Busboombot/usb-power-switch/design/cad/renders/bottom_molex.png

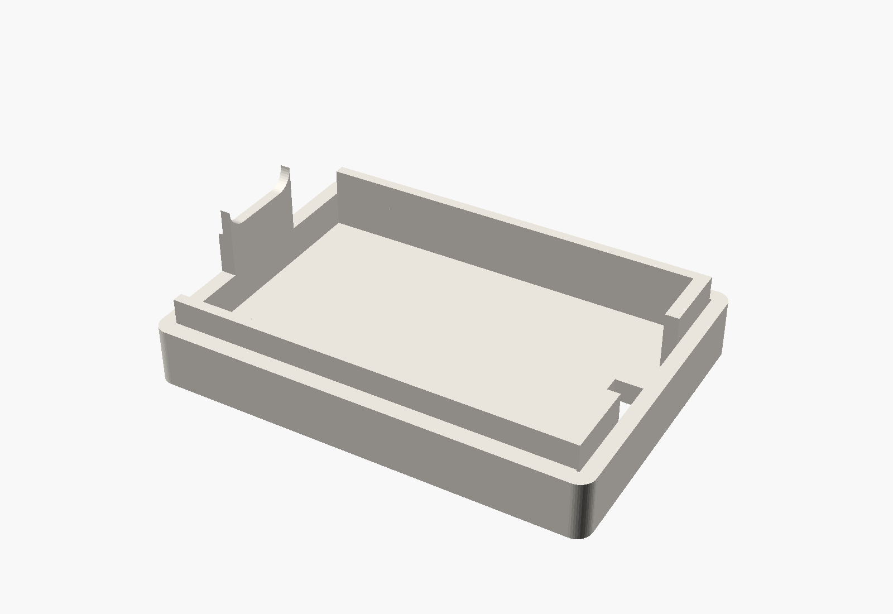
design/cad/renders/bottom_molex.png
