Busboombot/usb-power-switch/design/cad/renders/carrier_top.png

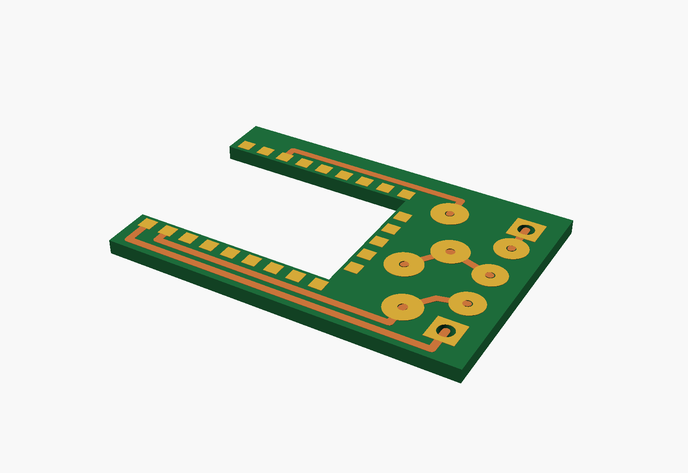
design/cad/renders/carrier_top.png
