Busboombot/usb-power-switch/design/cad/renders/lid_cable.png

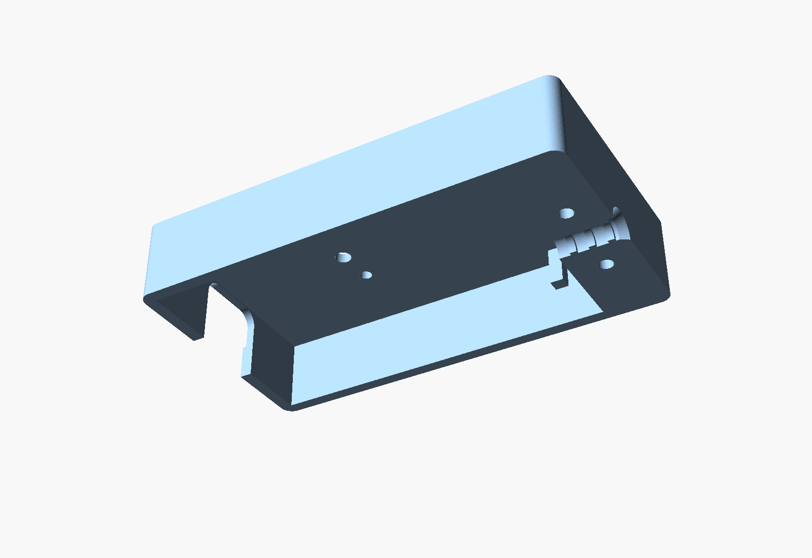
design/cad/renders/lid_cable.png
