Busboombot/usb-power-switch/design/cad/renders/module_bottom.png

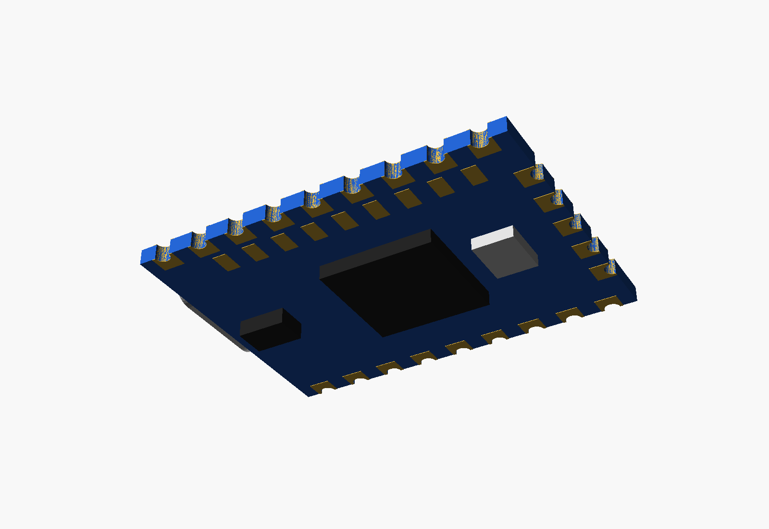
design/cad/renders/module_bottom.png
