Busboombot/usb-power-switch/design/cad/renders/section_molex.png

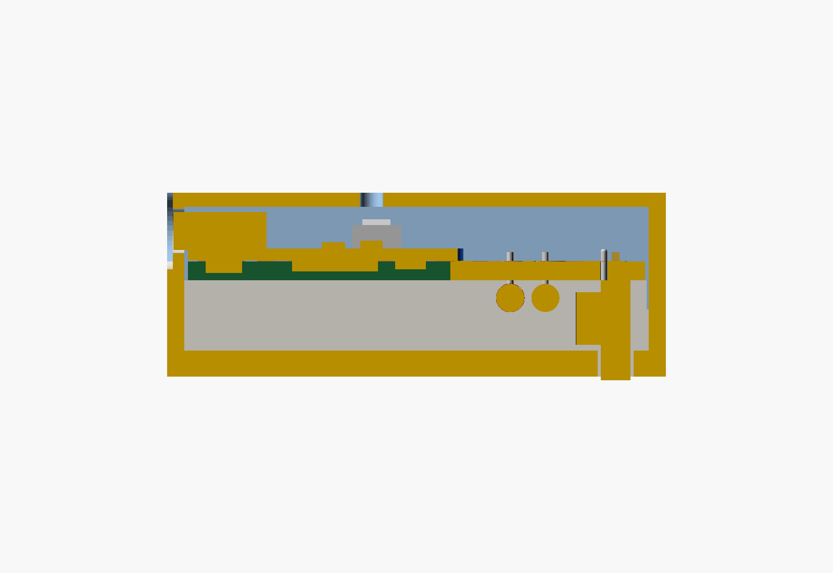
design/cad/renders/section_molex.png
