Busboombot/usb-power-switch/design/scan/height_bottom.png

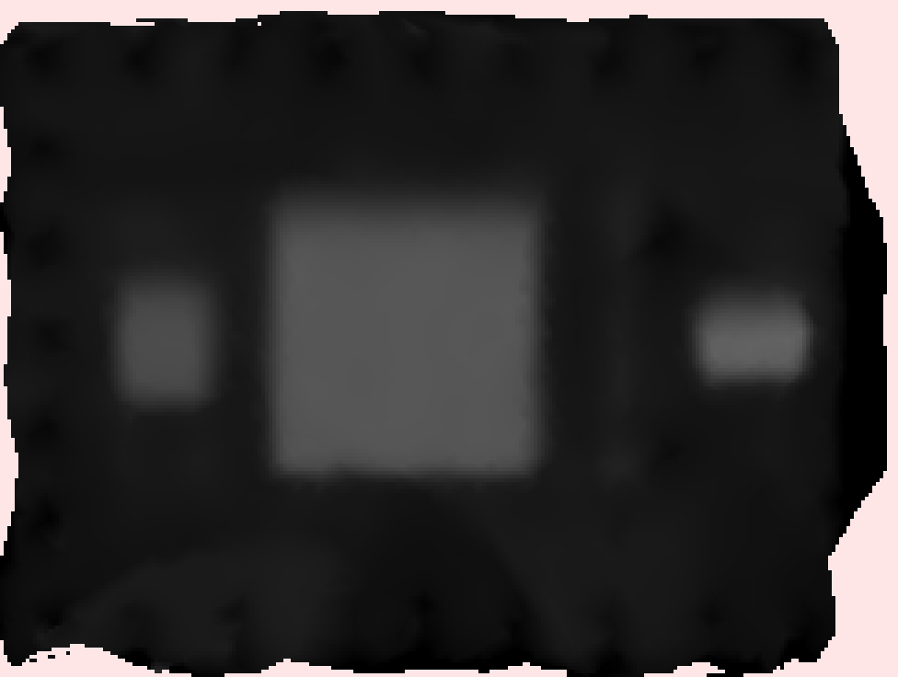
design/scan/height_bottom.png
