Busboombot/usb-power-switch/design/scan/height_top.png

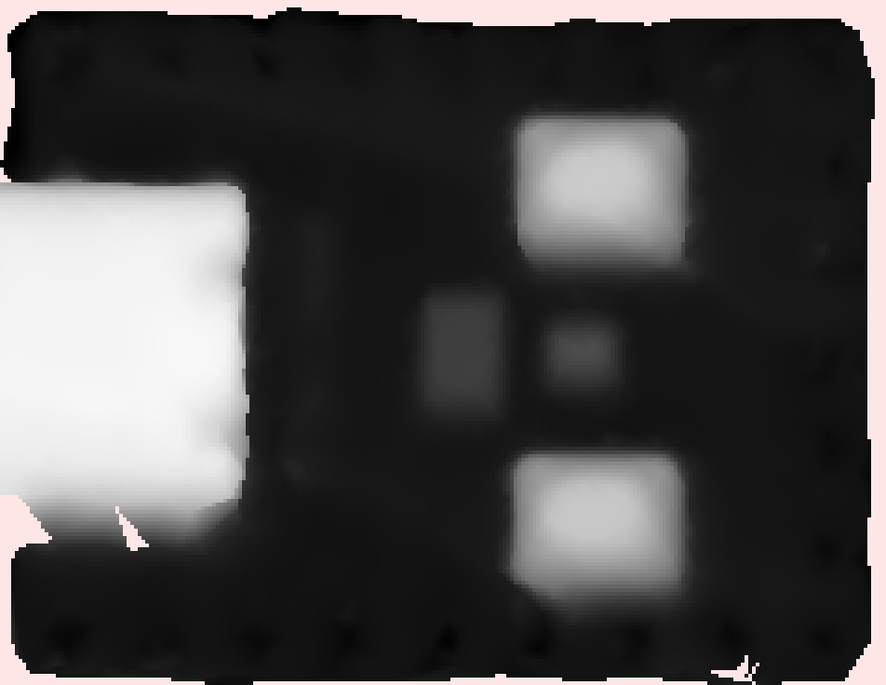
design/scan/height_top.png
