Busboombot/usb-power-switch/tools/mill/blank/pcb_blank_scan_170544.png

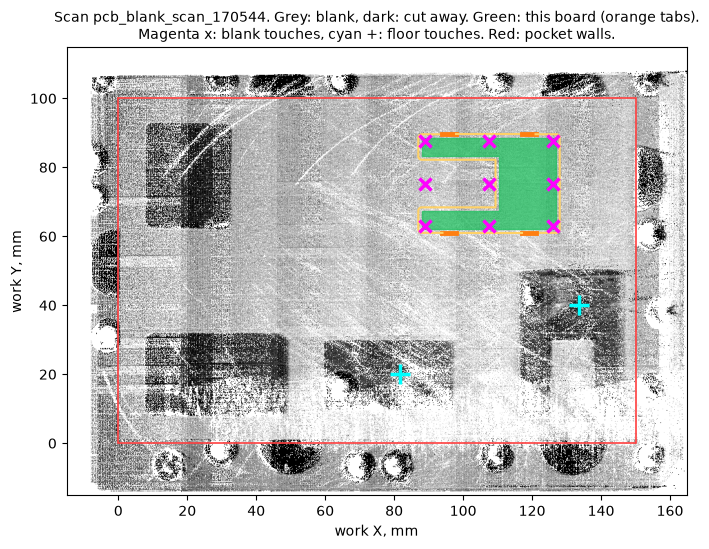
tools/mill/blank/pcb_blank_scan_170544.png
