Busboombot/usb-power-switch/tools/mill/blank/pcb_blank_scan_211856.png

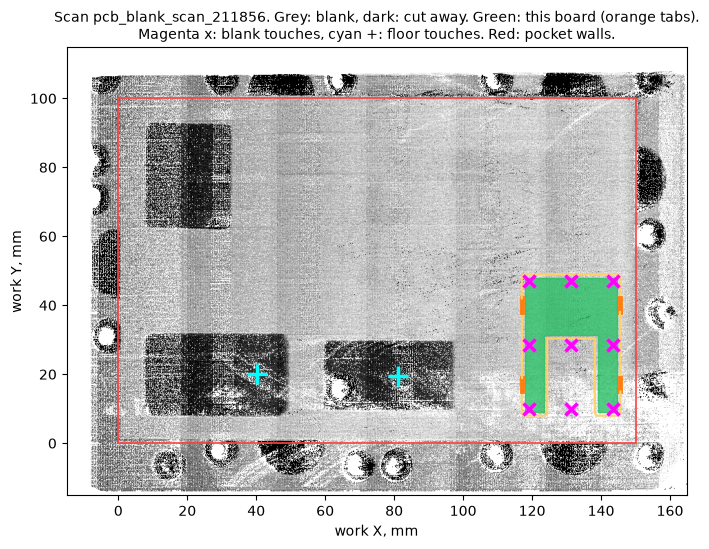
tools/mill/blank/pcb_blank_scan_211856.png
