Busboombot/usb-power-switch/design/scan/rp2040-zero-scan.stl

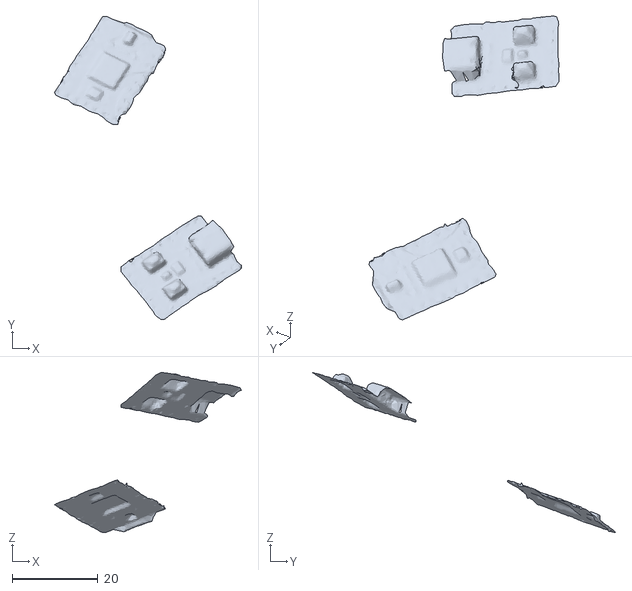
[picture p20: CAD file, 2026-11-08]
design/scan/rp2040-zero-scan.stl
43.5 x 70.6 x 37.3
