Busboombot/usb-power-switch/design/cad/renders/assembly_cable.png

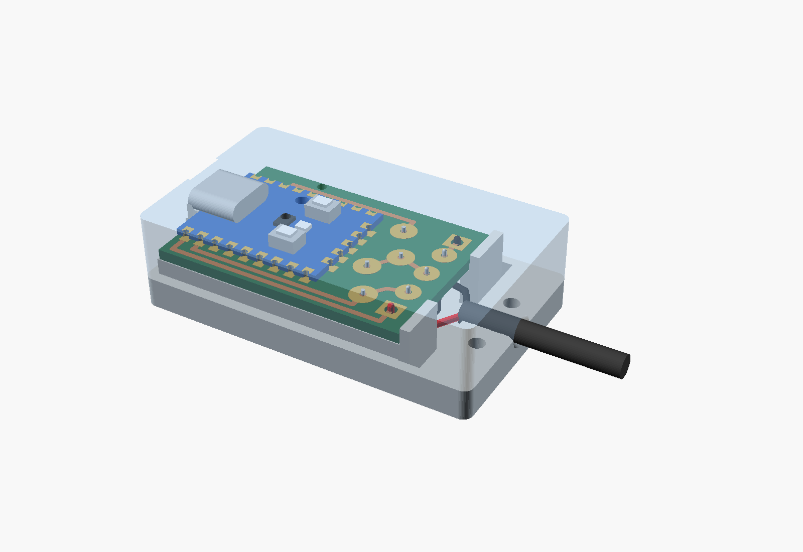
design/cad/renders/assembly_cable.png
