Busboombot/usb-power-switch/design/cad/renders/assembly_cable_back.png

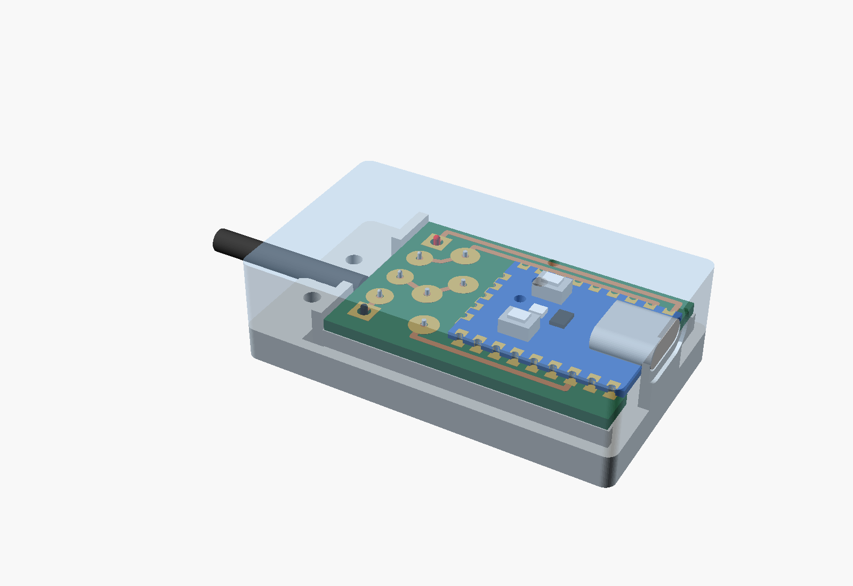
design/cad/renders/assembly_cable_back.png
