Busboombot/usb-power-switch/design/cad/renders/assembly_molex.png

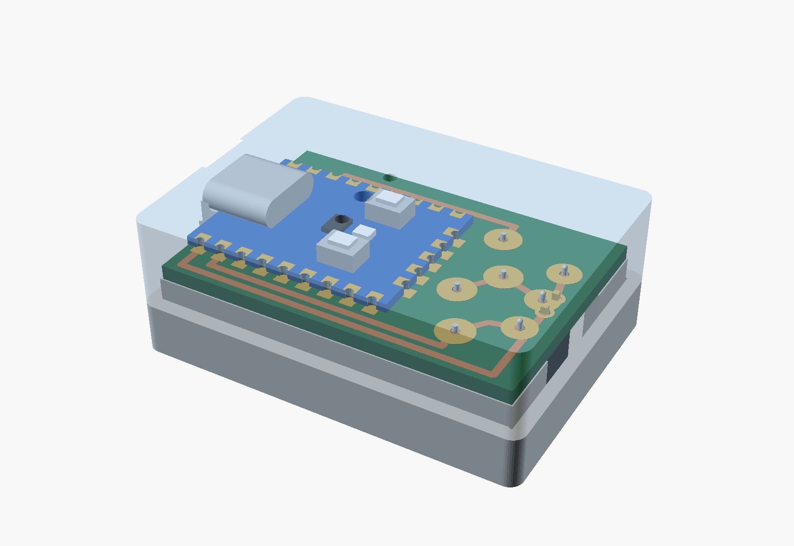
design/cad/renders/assembly_molex.png
