Busboombot/usb-power-switch/design/cad/renders/carrier_assembly.png

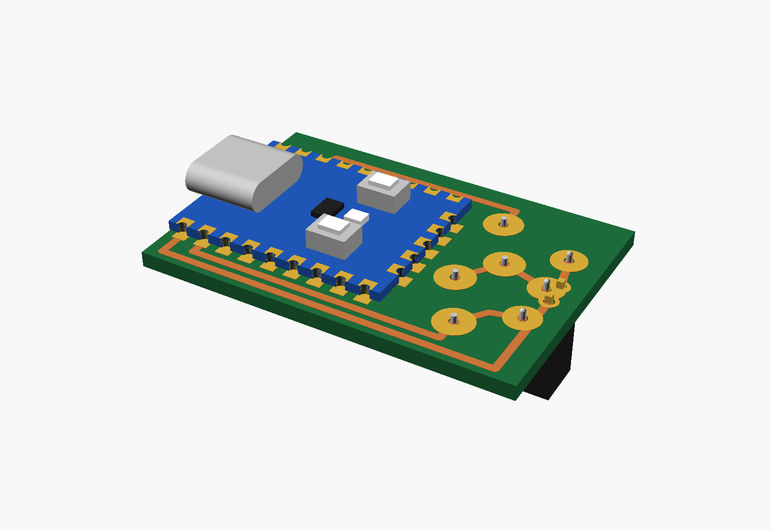
design/cad/renders/carrier_assembly.png
