Busboombot/usb-power-switch/(list of files, drawings)

Other design files:
tools/mill/blank/pcb_blank_scan_170544.json
tools/mill/blank/pcb_blank_scan_211856.json
