Busboombot/usb-power-switch/(commit log)

2026-11-08 Add initial project files: .gitignore, README, circuit design, code, and deployment script
2026-11-08 Refactor code structure and remove redundant sections for improved readability and maintainability
    [rp2040-zero-scan.stl, usb_power_switch.scad]
2026-11-08 Add 3D viewer, printing tools, and GitHub Pages config
    - design/viewer/: builds viewer/cable.html and viewer/molex.html from the
    OpenSCAD model (just viewer). Each part can be shown, ghosted or hidden;
    explode, section cuts, click-to-identify and measuring.
    - tools/print/: slicing script and flattened Bambu A1 profiles (just
    slice), plus scripts to check, photograph and send jobs to the printers.
    - _config.yml: serve the repo as a GitHub Pages site.
    - Remove a stray slicer result.json.
    [machine_a1.json, pieces.scad]
2026-11-08 Cable case: stop the carrier sliding back
    The gap behind the carrier, where the wires turn up into J1, let the
    board slide back. Two posts behind the back corners now rise from the
    floor to 1 mm above the carrier's top face, 0.2 mm behind its back
    edge, clear of the wires and clamp screws.
    [usb_power_switch.scad]
2026-11-11 Add CAM and placement scripts for USB power switch carrier board
    - Implemented `cam.py` to generate toolpaths for milling the carrier board from an OpenSCAD model. This includes isolation, clearing, drilling, and outlining paths, along with generating a preview image and JSON output for the milling job.
    - Created `place.py` to position the carrier on a PCB blank based on a height grid scan. This script calculates the placement, generates floor touch points, and outputs the job details and visualizations.
    [pcb_blank_scan_170544.json, pcb_blank_scan_211856.json, usb_power_switch.scad]
